prateekspawar/Airbus_Gripper_design_challenge/circuit diagram/ir.jpg

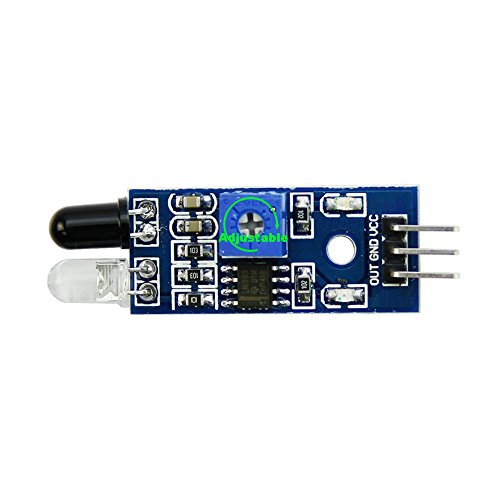
circuit diagram/ir.jpg
