prateekspawar/Airbus_Gripper_design_challenge/circuit diagram/servo.jpg

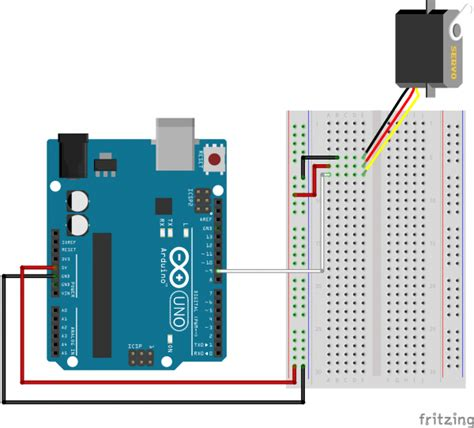
circuit diagram/servo.jpg
