prateekspawar/Airbus_Gripper_design_challenge/README.md

# Airbus_Gripper_design_challenge
## Final submission report [here](Grasping%20System%20-%20Submission%20Prateek%20Pawar.pdf).
