prateekspawar/Airbus_Gripper_design_challenge/servo.txt

https://robokits.co.in/motors/rc-servo-motors/metal-gear-dual-shaft-16kgcm-digital-servo-motor

https://robu.in/product/towerpro-mg995-metal-gear-servo-motor/

https://robokits.co.in/robot-parts/servo-brackets-accessories/servo-accessory-pack-for-dual-shaft-servo

https://robokits.co.in/motors/rc-servo-motors/metal-horn-for-servo-25t

https://robokits.co.in/sensors/ir-and-pir-sensors/ir-obstacle-sensor-module
