prateekspawar/Airbus_Gripper_design_challenge/RKI-1206.pdf

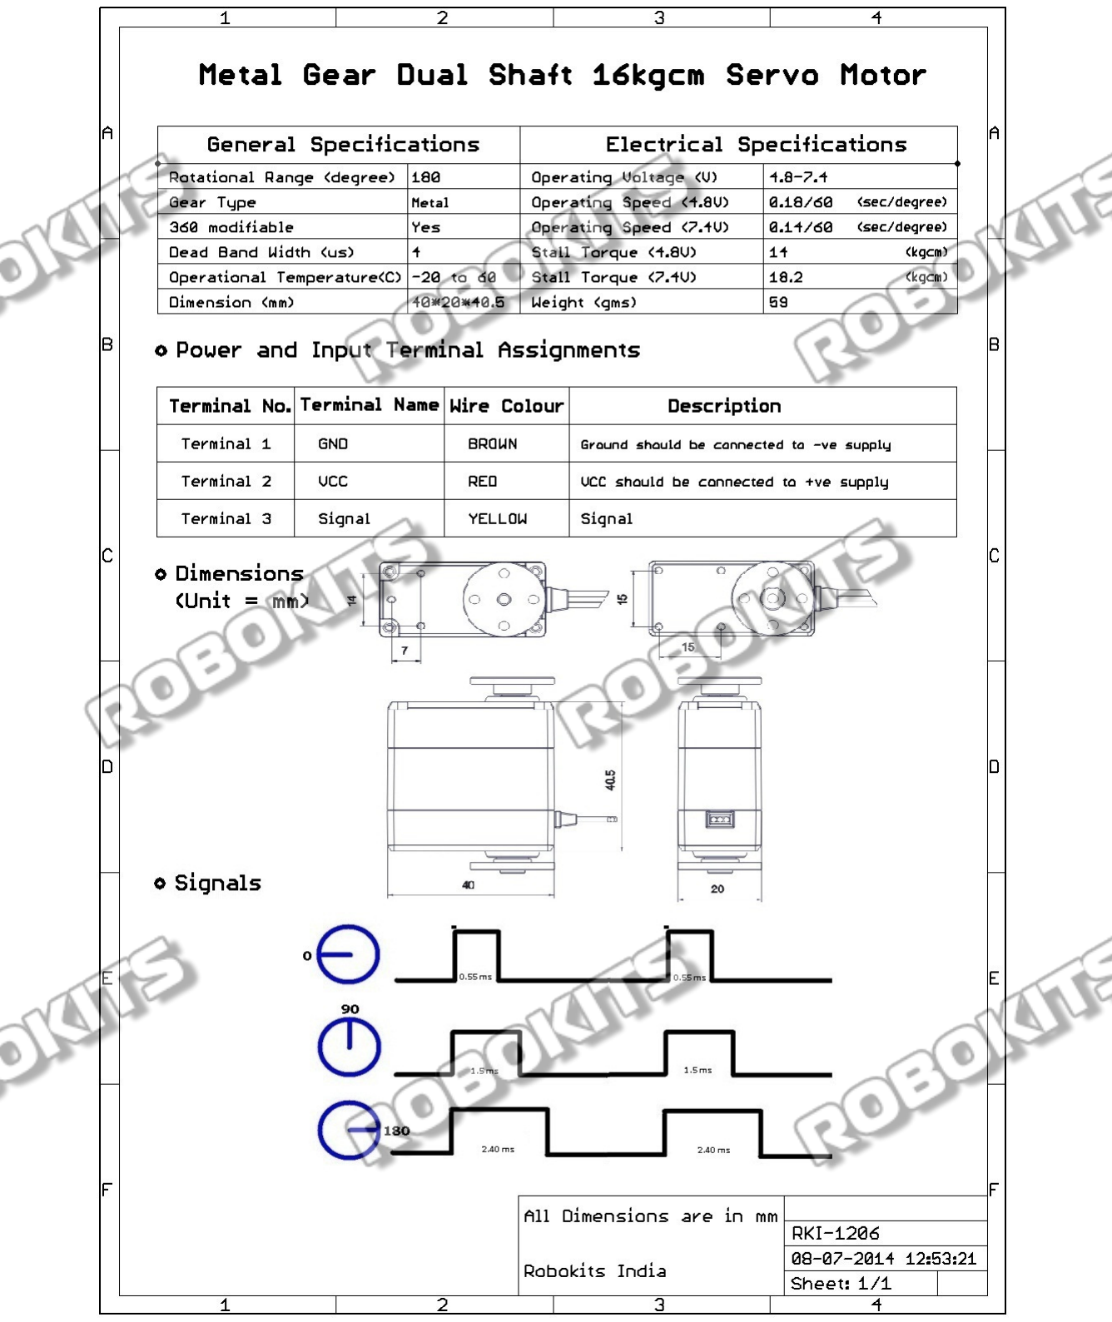
[picture p26: page 1]
