prateekspawar/Airbus_Gripper_design_challenge/circuit diagram/ultrasonic.jpg

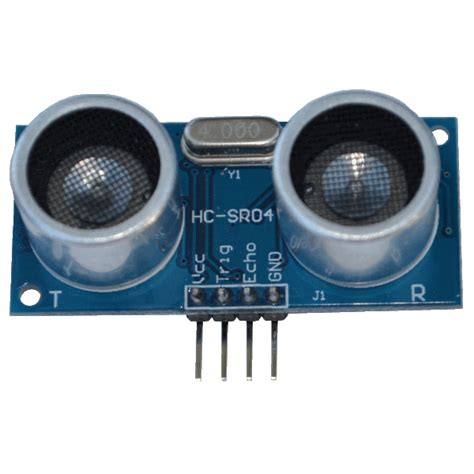
circuit diagram/ultrasonic.jpg
