prateekspawar/Airbus_Gripper_design_challenge/solidwrks/Screenshot (31).png

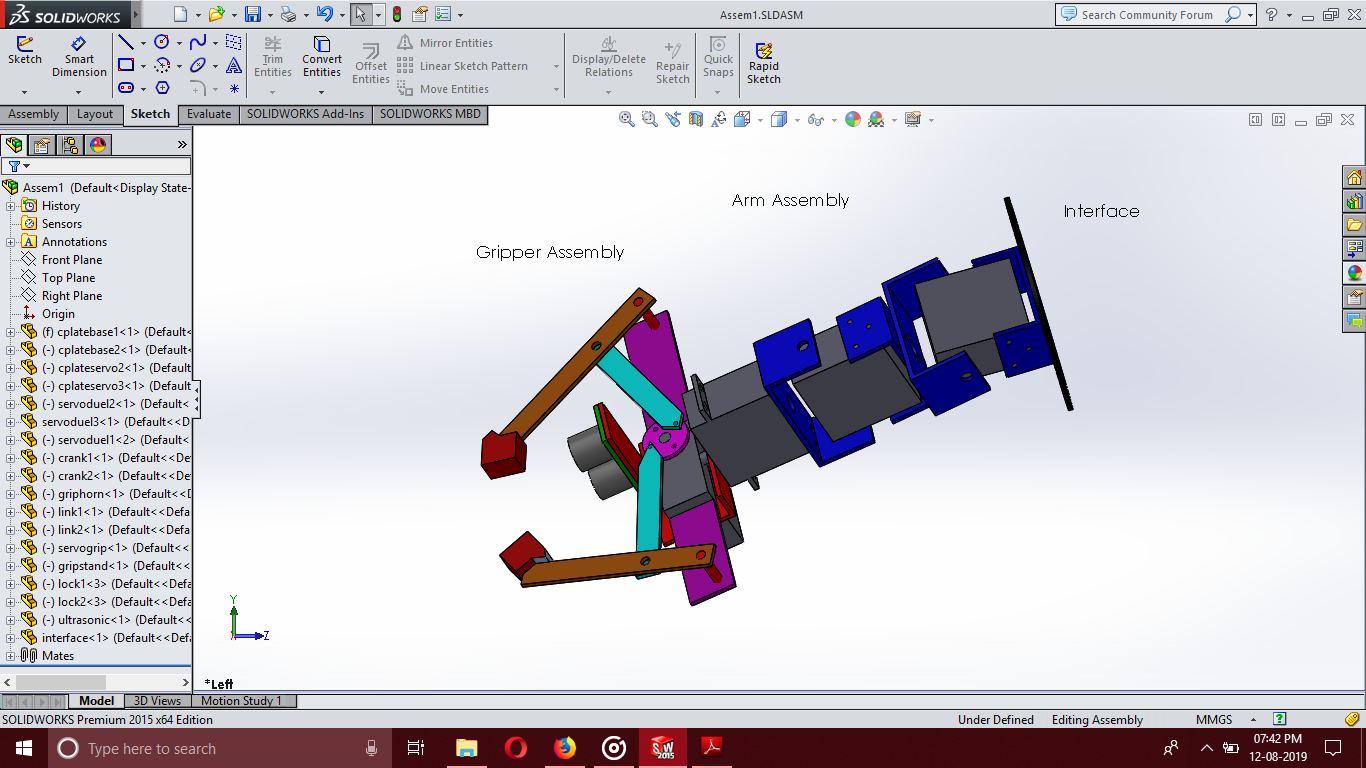
solidwrks/Screenshot (31).png
