prateekspawar/Airbus_Gripper_design_challenge/solidwrks/Screenshot (32).png

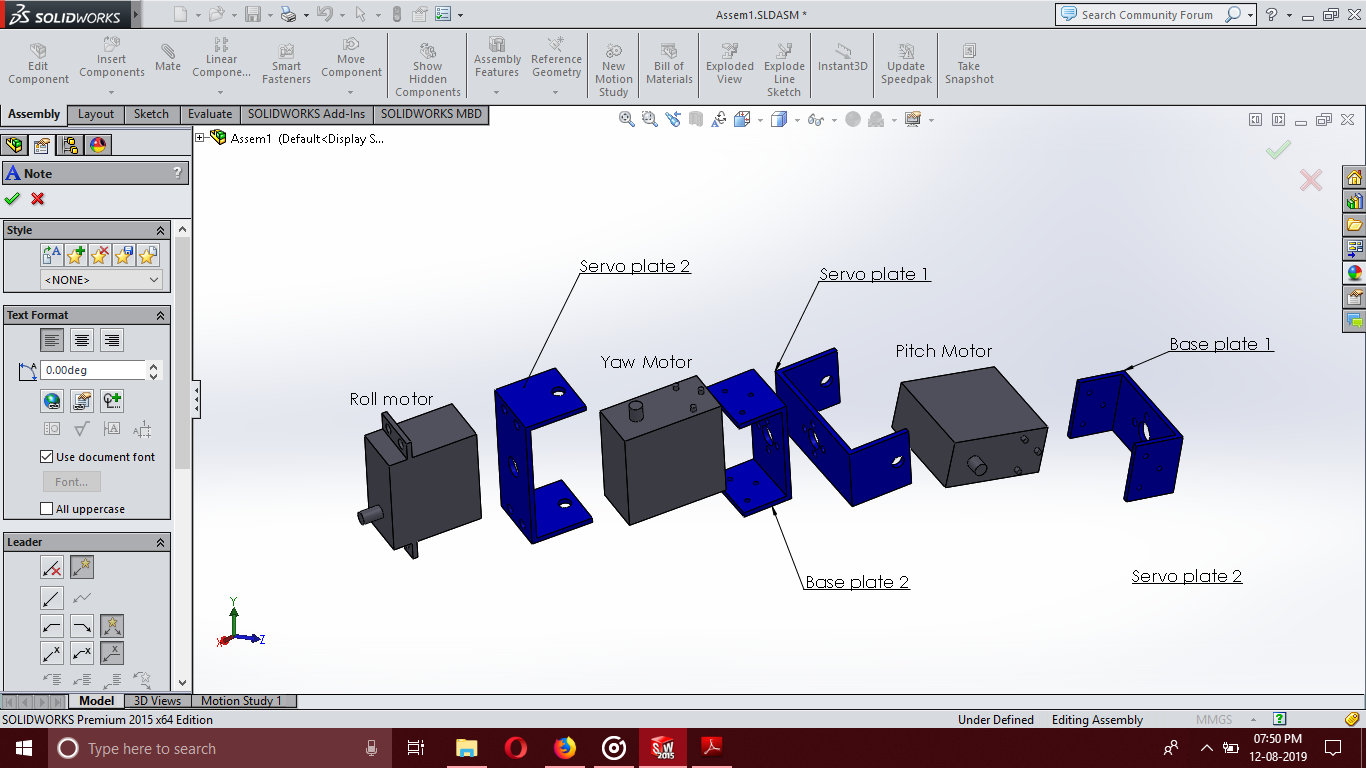
solidwrks/Screenshot (32).png
