prateekspawar/Airbus_Gripper_design_challenge/solidwrks/Screenshot (35).png

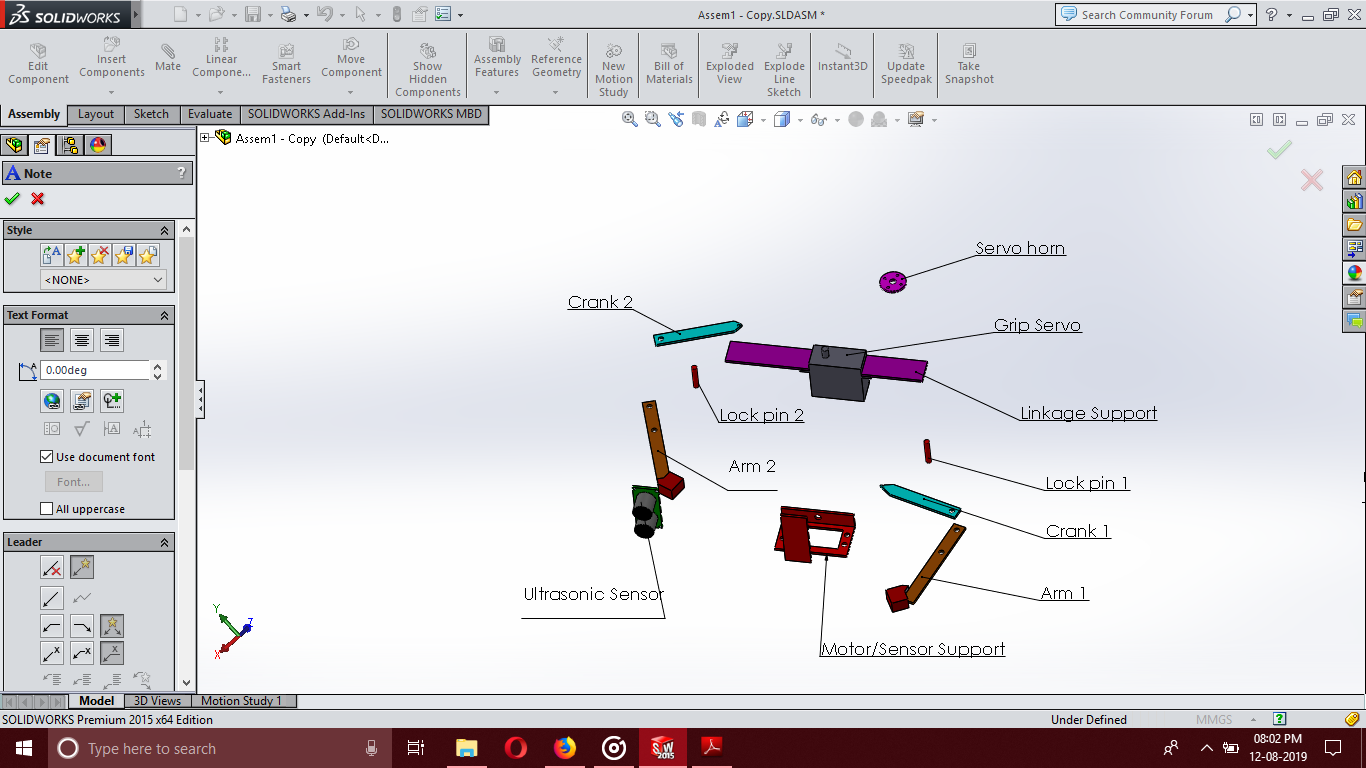
solidwrks/Screenshot (35).png
