prateekspawar/Airbus_Gripper_design_challenge/solidwrks/Screenshot (57).png

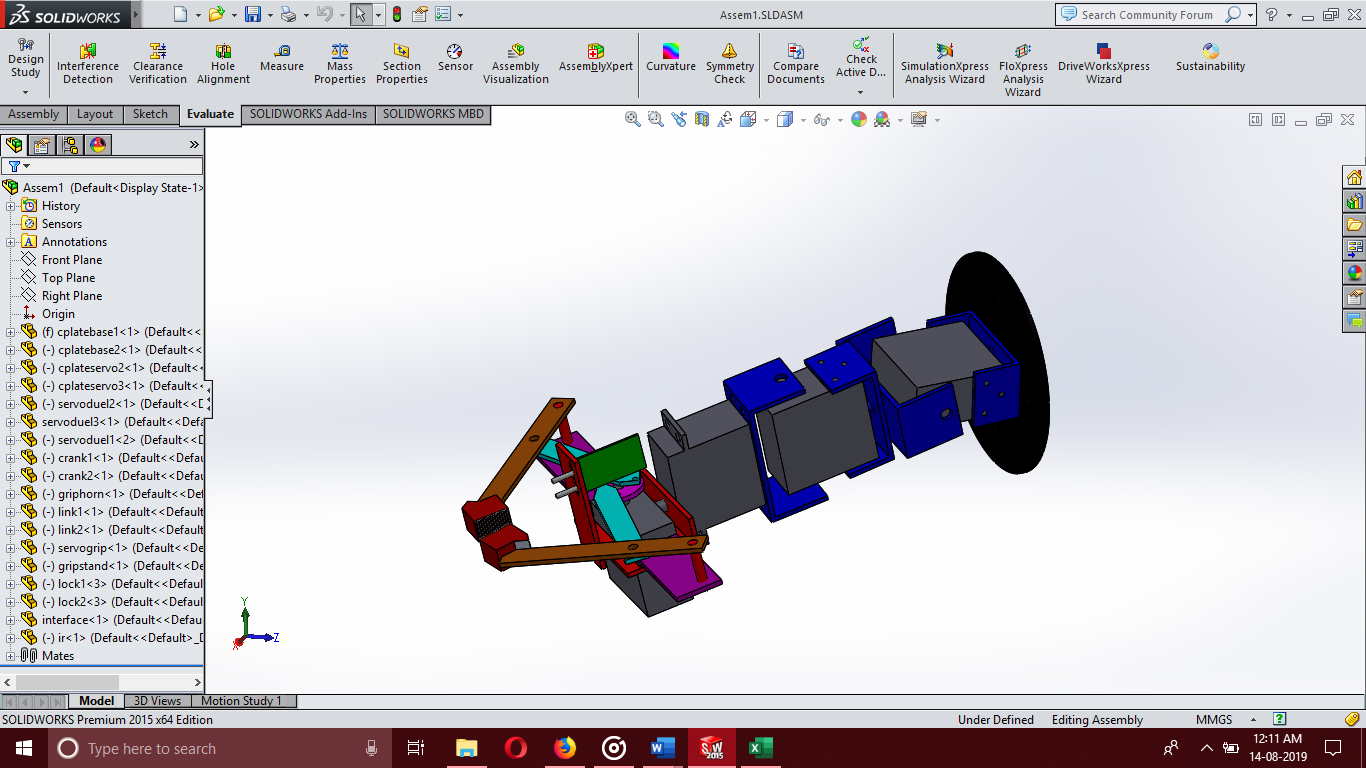
solidwrks/Screenshot (57).png
