prateekspawar/Airbus_Gripper_design_challenge/solidwrks/Screenshot (66).png

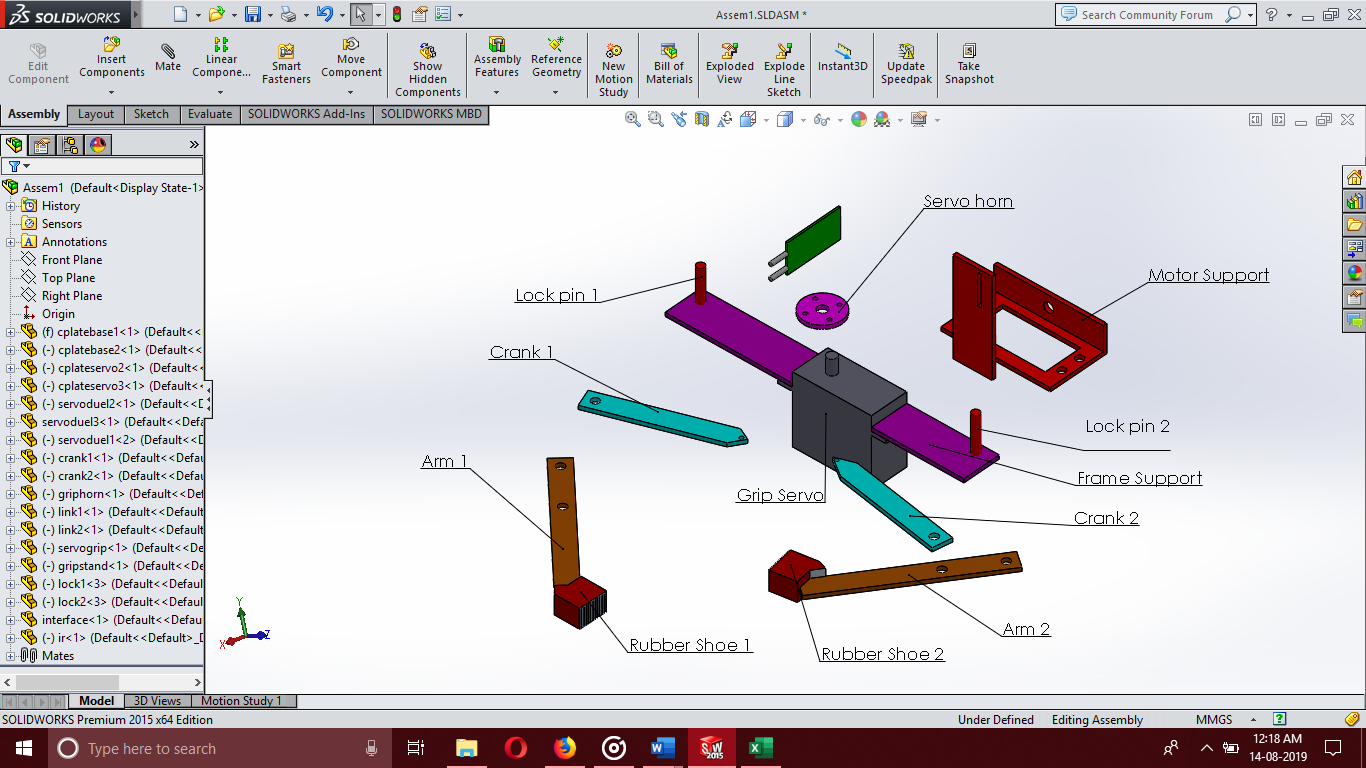
solidwrks/Screenshot (66).png
