prateekspawar/Airbus_Gripper_design_challenge/solidwrks/Screenshot (67).png

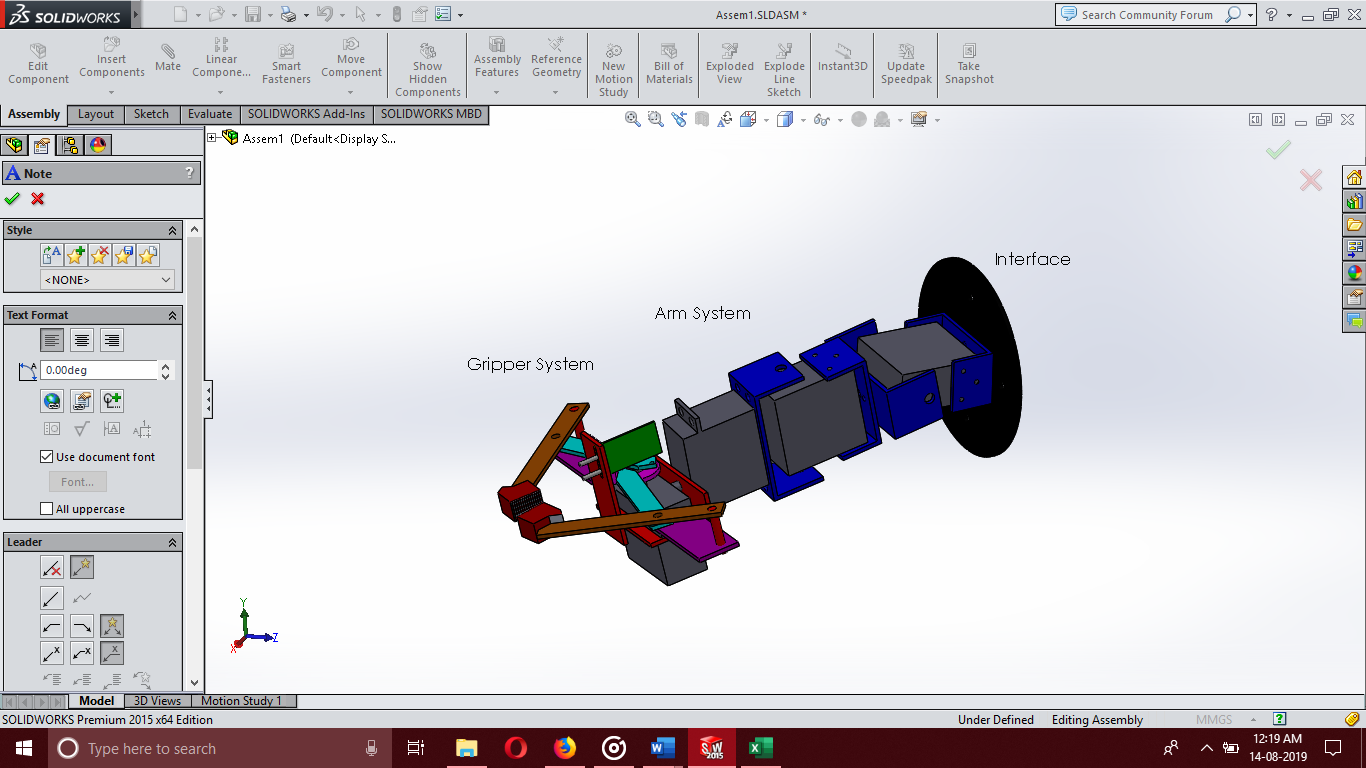
solidwrks/Screenshot (67).png
