prateekspawar/Airbus_Gripper_design_challenge/solidwrks/Assem1.SLDASM

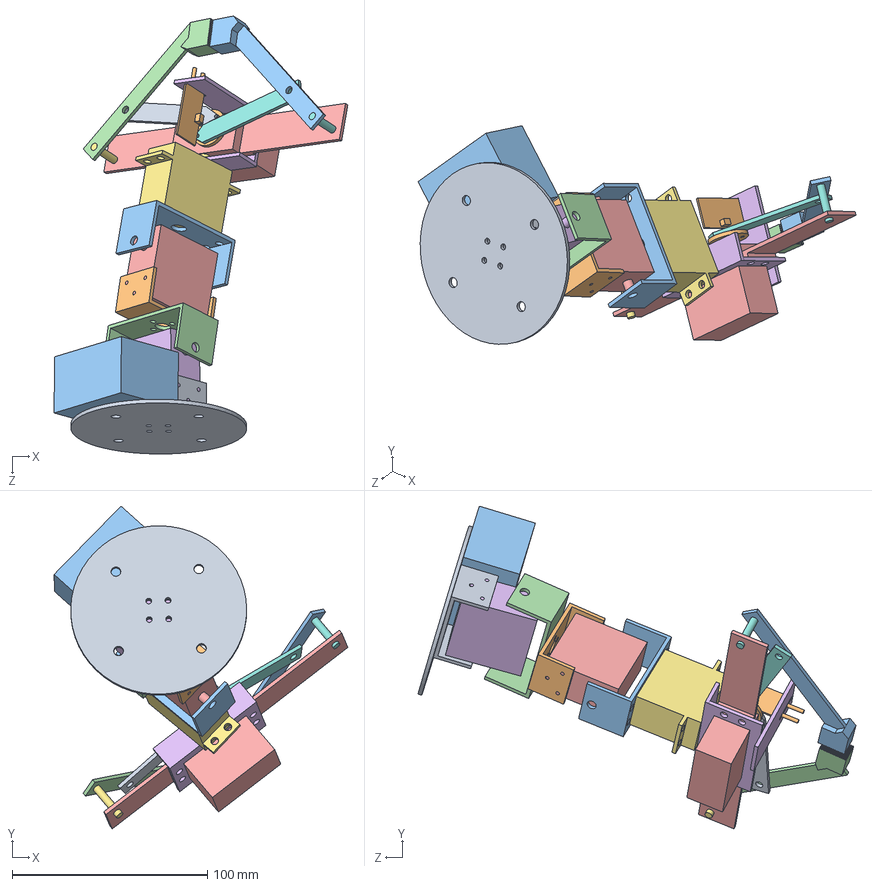
[picture p34: CAD file, 2020-05-11]
solidwrks/Assem1.SLDASM
150.3 x 165.1 x 224.1 mm
cplatebase1
cplatebase2
cplateservo2
cplateservo3
servoduel2
servoduel3
servoduel1
crank1
crank2
griphorn
link1
link2
servogrip
gripstand
lock1
lock2
interface
ir
electronics box
