prateekspawar/Airbus_Gripper_design_challenge/solidwrks/drawings/Arm/cplateservo3.SLDPRT

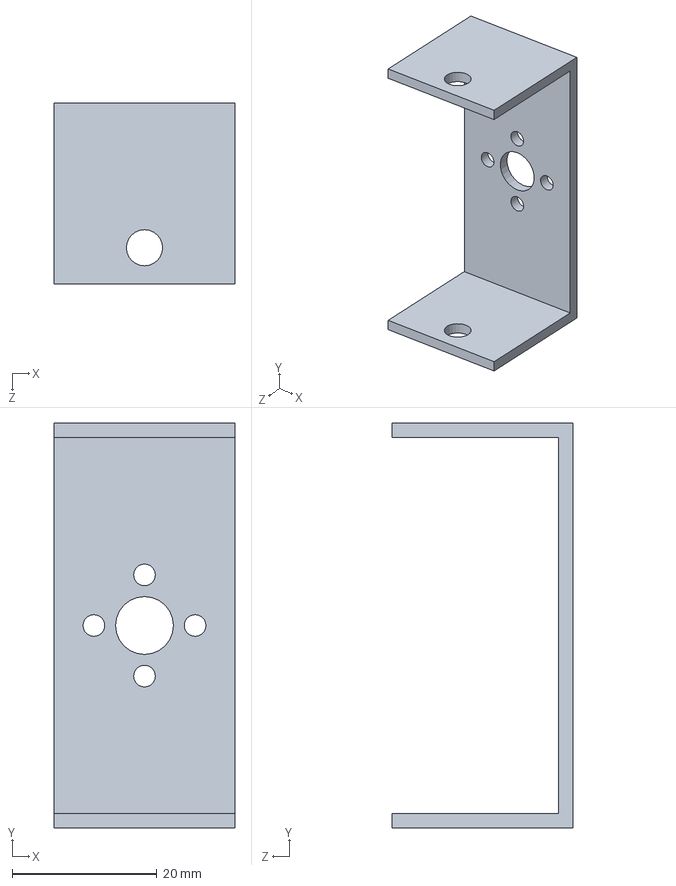
[picture p35: CAD file, 2020-05-11]
solidwrks/drawings/Arm/cplateservo3.SLDPRT
25.0 x 56.0 x 25.0 mm
