prateekspawar/Airbus_Gripper_design_challenge/solidwrks/drawings/gripper/arm1.SLDPRT

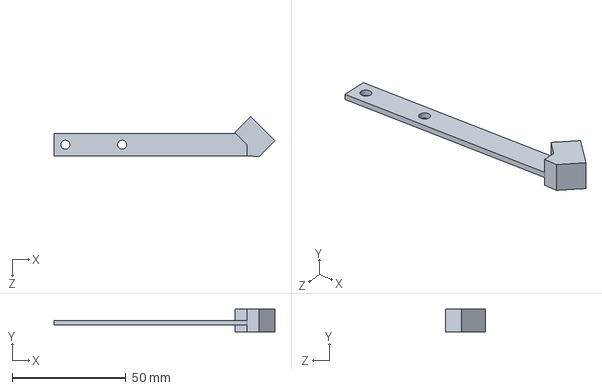
[picture p36: CAD file, 2020-05-11]
solidwrks/drawings/gripper/arm1.SLDPRT
97.3 x 10.0 x 17.7 mm
