prateekspawar/Airbus_Gripper_design_challenge/solidwrks/drawings/interface/interface.SLDPRT

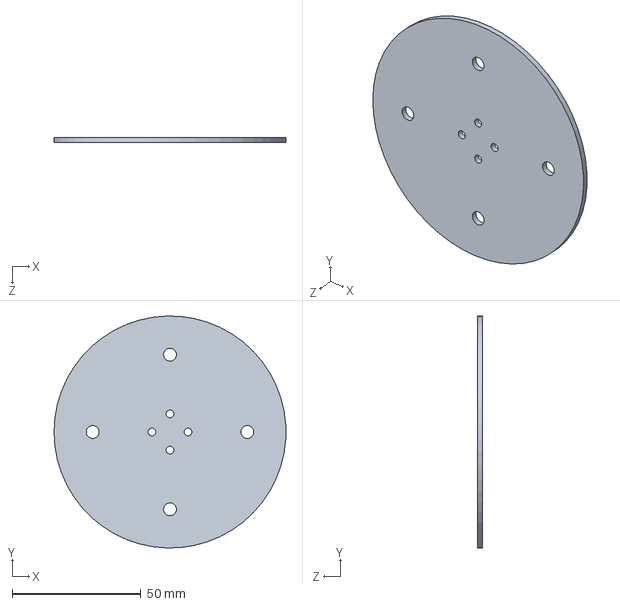
[picture p37: CAD file, 2020-05-11]
solidwrks/drawings/interface/interface.SLDPRT
90.0 x 90.0 x 2.00 mm
