prateekspawar/Airbus_Gripper_design_challenge/solidwrks/gripstand.SLDPRT

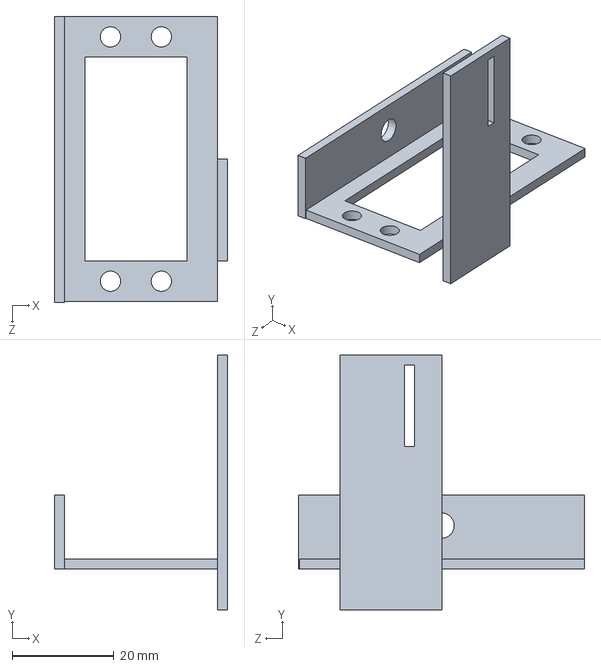
[picture p38: CAD file, 2020-05-11]
solidwrks/gripstand.SLDPRT
34.0 x 50.0 x 56.2 mm
