prateekspawar/Airbus_Gripper_design_challenge/solidwrks/cplateservo2.SLDPRT

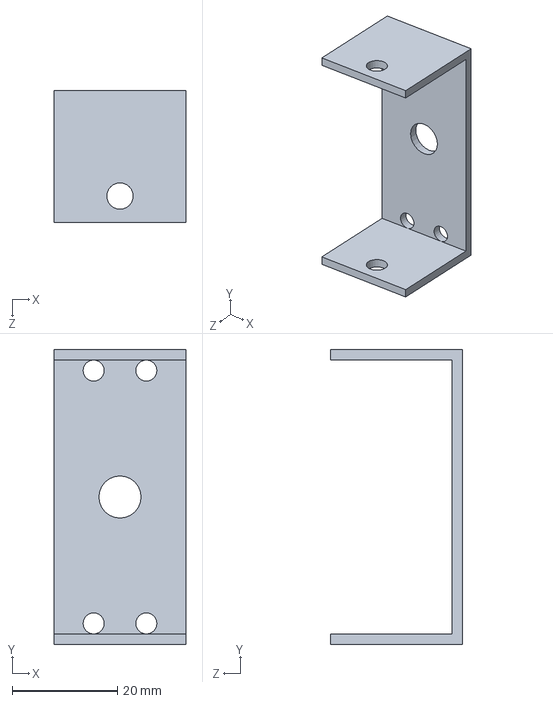
[picture p39: CAD file, 2020-05-11]
solidwrks/cplateservo2.SLDPRT
25.0 x 56.0 x 25.0 mm
