prateekspawar/Airbus_Gripper_design_challenge/solidwrks/drawings/Arm/cplatebase2.SLDPRT

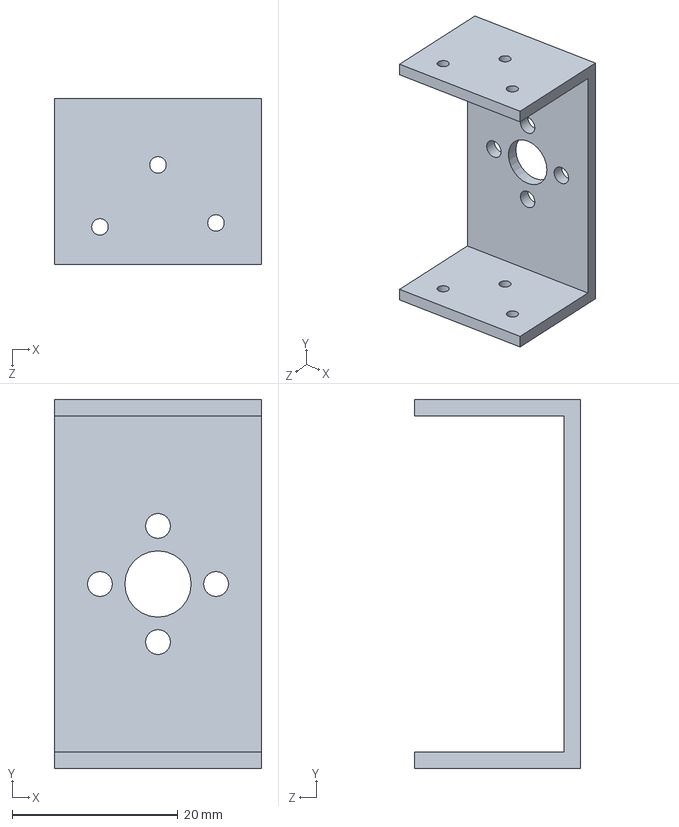
[picture p40: CAD file, 2020-05-11]
solidwrks/drawings/Arm/cplatebase2.SLDPRT
25.0 x 44.5 x 20.0 mm
