prateekspawar/Airbus_Gripper_design_challenge/solidwrks/drawings/gripper/crank2.SLDPRT

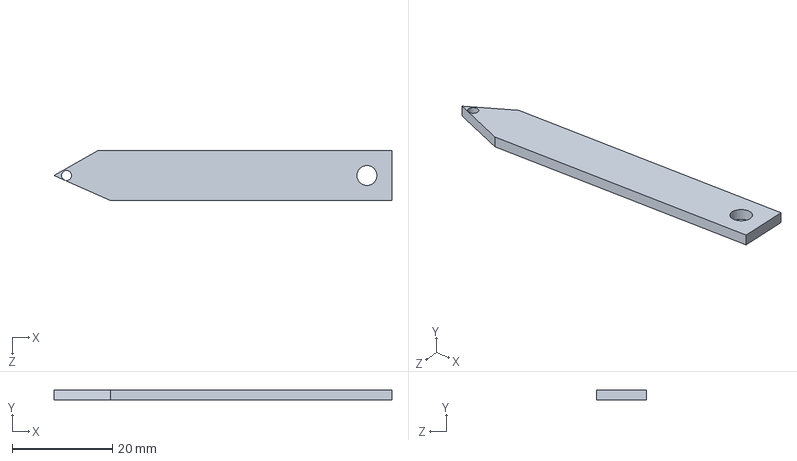
[picture p41: CAD file, 2020-05-11]
solidwrks/drawings/gripper/crank2.SLDPRT
67.5 x 2.00 x 10.0 mm
