prateekspawar/Airbus_Gripper_design_challenge/solidwrks/drawings/Arm/servoyaw.SLDPRT

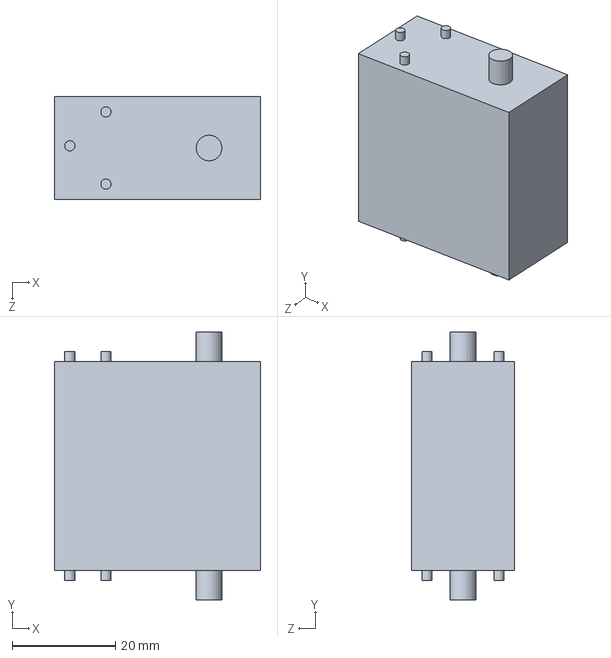
[picture p42: CAD file, 2020-05-11]
solidwrks/drawings/Arm/servoyaw.SLDPRT
40.0 x 52.0 x 20.0 mm
