prateekspawar/Airbus_Gripper_design_challenge/solidwrks/drawings/gripper/servogrip.SLDPRT

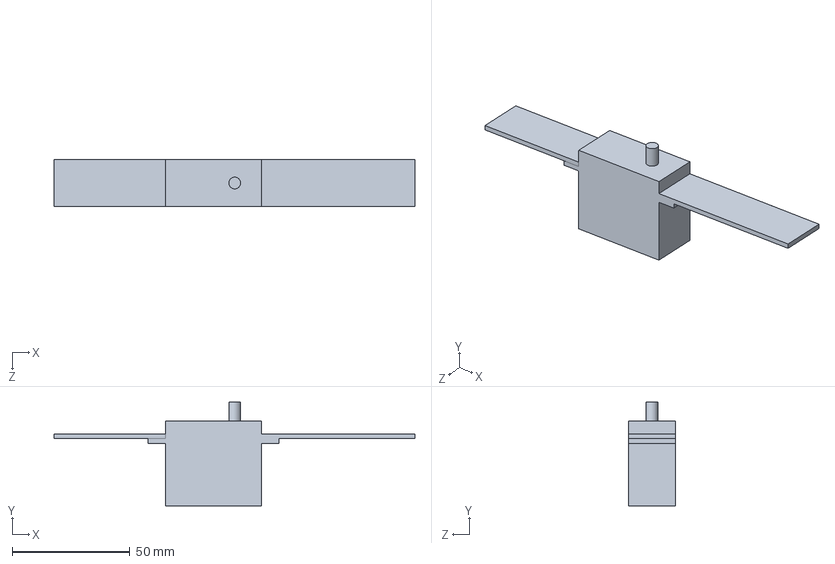
[picture p43: CAD file, 2020-05-11]
solidwrks/drawings/gripper/servogrip.SLDPRT
153.1 x 44.1 x 20.0 mm
