prateekspawar/Airbus_Gripper_design_challenge/solidwrks/lock1.SLDPRT

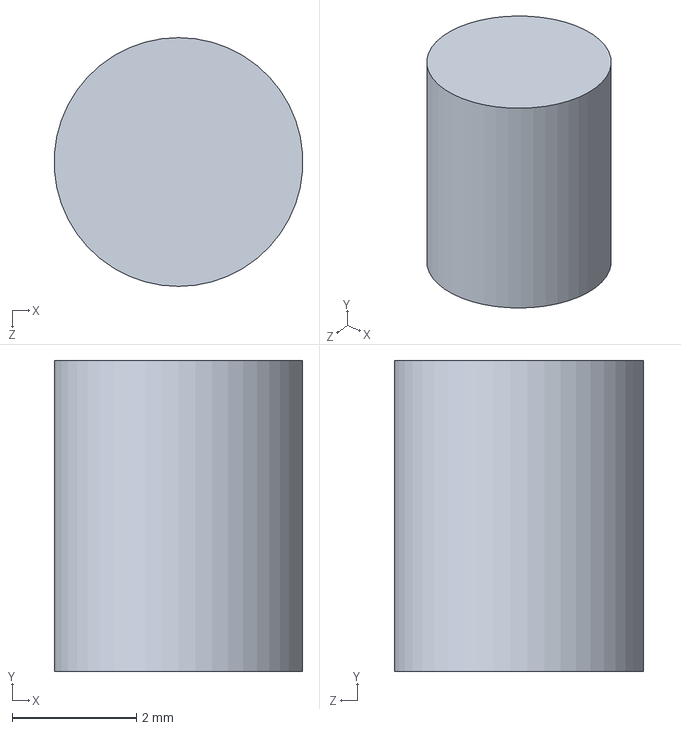
[picture p44: CAD file, 2020-05-11]
solidwrks/lock1.SLDPRT
3.99 x 5.00 x 4.00 mm
