prateekspawar/Airbus_Gripper_design_challenge/solidwrks/drawings/gripper/arm2.SLDPRT

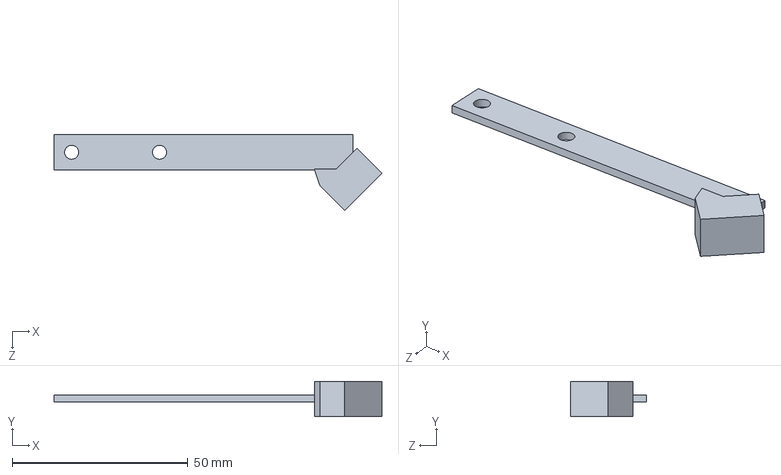
[picture p45: CAD file, 2020-05-11]
solidwrks/drawings/gripper/arm2.SLDPRT
93.2 x 10.0 x 21.5 mm
