prateekspawar/Airbus_Gripper_design_challenge/solidwrks/drawings/Arm/servoroll.SLDPRT

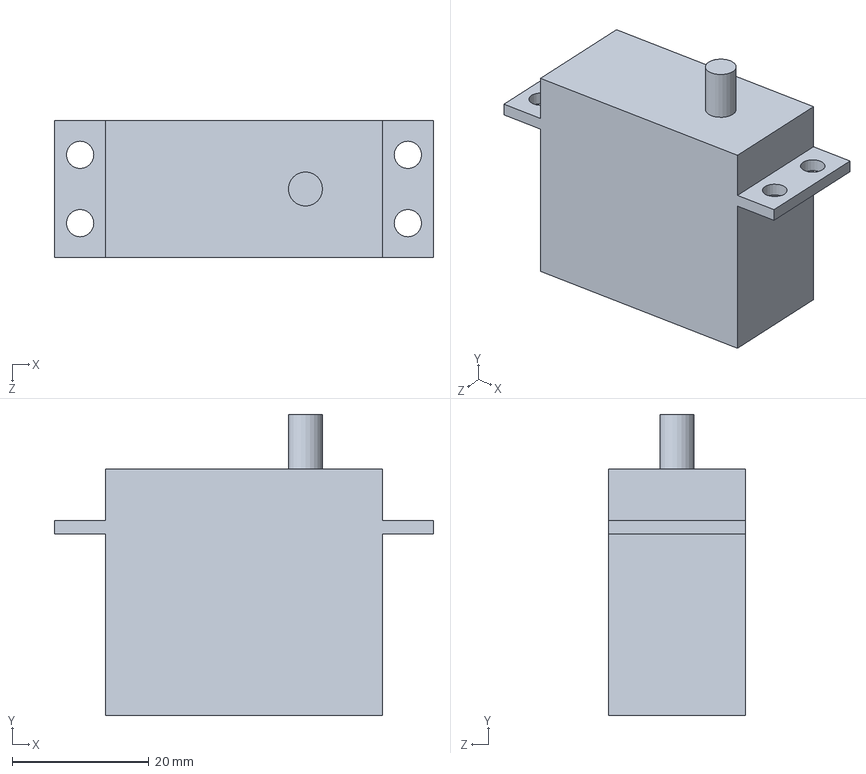
[picture p46: CAD file, 2020-05-11]
solidwrks/drawings/Arm/servoroll.SLDPRT
55.5 x 44.1 x 20.0 mm
