prateekspawar/Airbus_Gripper_design_challenge/solidwrks/cplateservo1.SLDPRT

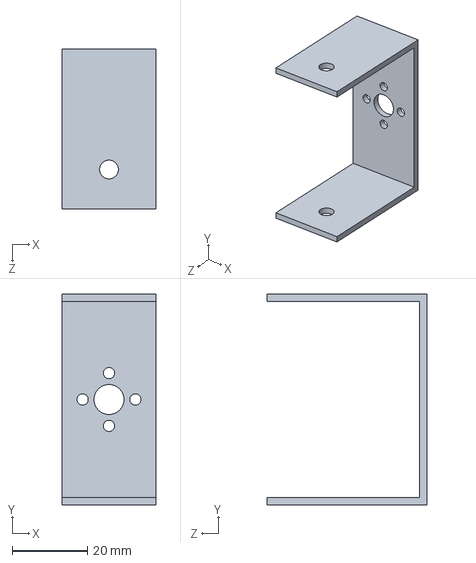
[picture p47: CAD file, 2020-05-11]
solidwrks/cplateservo1.SLDPRT
25.0 x 56.0 x 42.5 mm
