prateekspawar/Airbus_Gripper_design_challenge/solidwrks/drawings/gripper/servohorn.SLDPRT

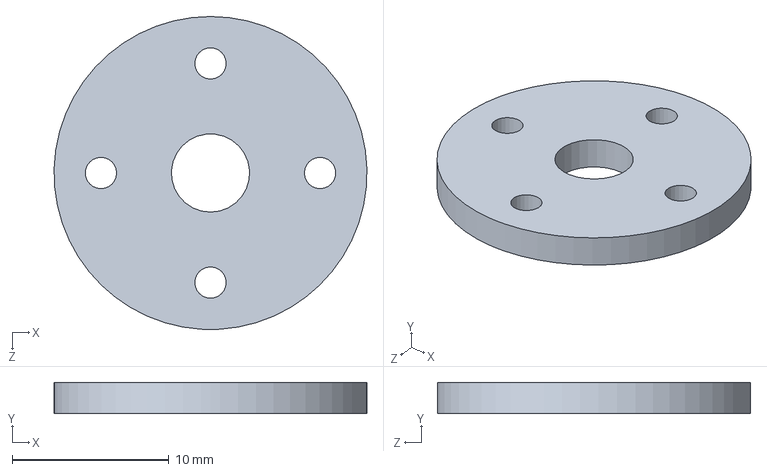
[picture p48: CAD file, 2020-05-11]
solidwrks/drawings/gripper/servohorn.SLDPRT
20.0 x 2.00 x 20.0 mm
