prateekspawar/Airbus_Gripper_design_challenge/solidwrks/drawings/gripper/ultrasonic.SLDPRT

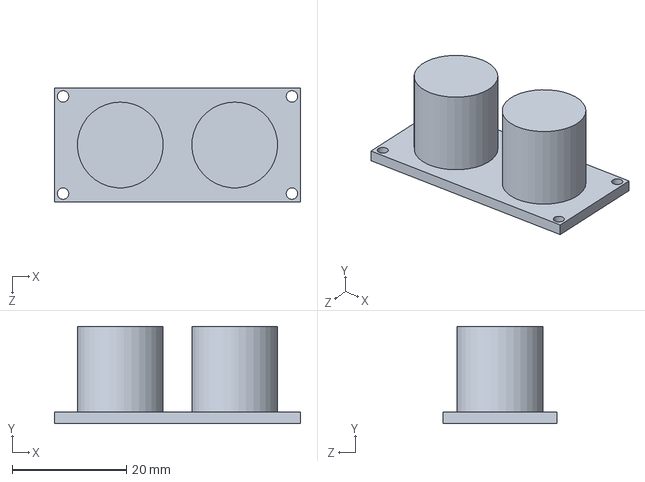
[picture p49: CAD file, 2020-05-11]
solidwrks/drawings/gripper/ultrasonic.SLDPRT
43.0 x 17.0 x 20.0 mm
