prateekspawar/Airbus_Gripper_design_challenge/solidwrks/link1.SLDPRT

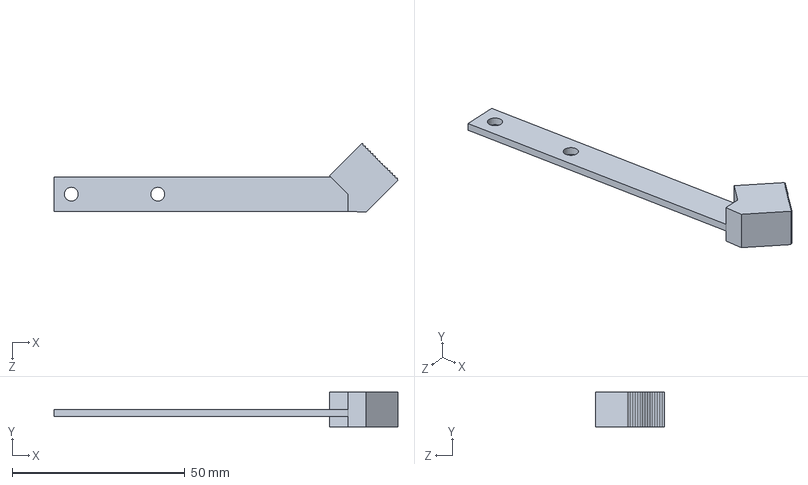
[picture p50: CAD file, 2020-05-11]
solidwrks/link1.SLDPRT
99.4 x 10.0 x 19.8 mm
