prateekspawar/Airbus_Gripper_design_challenge/solidwrks/link2.SLDPRT

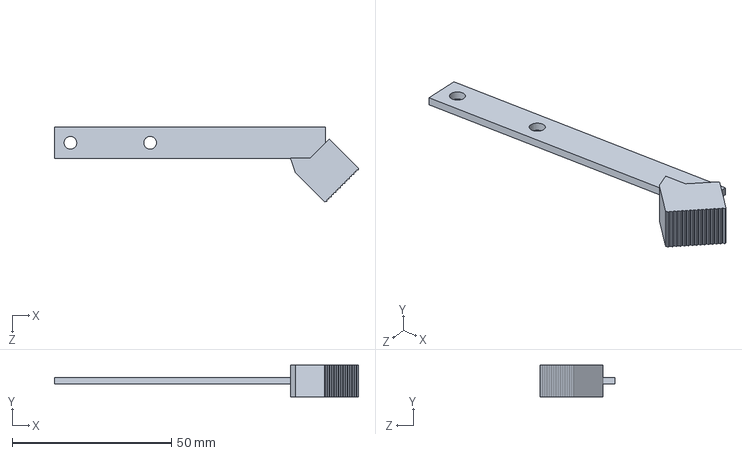
[picture p51: CAD file, 2020-05-11]
solidwrks/link2.SLDPRT
95.4 x 10.0 x 23.6 mm
