prateekspawar/Airbus_Gripper_design_challenge/solidwrks/ir.SLDPRT

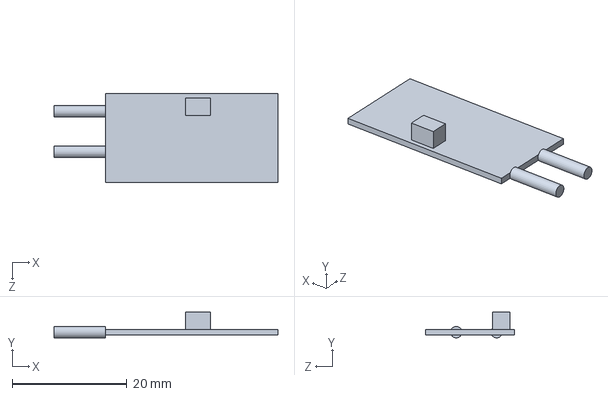
[picture p52: CAD file, 2020-05-11]
solidwrks/ir.SLDPRT
39.0 x 4.50 x 15.5 mm
