prateekspawar/Airbus_Gripper_design_challenge/solidwrks/electronics box.SLDPRT

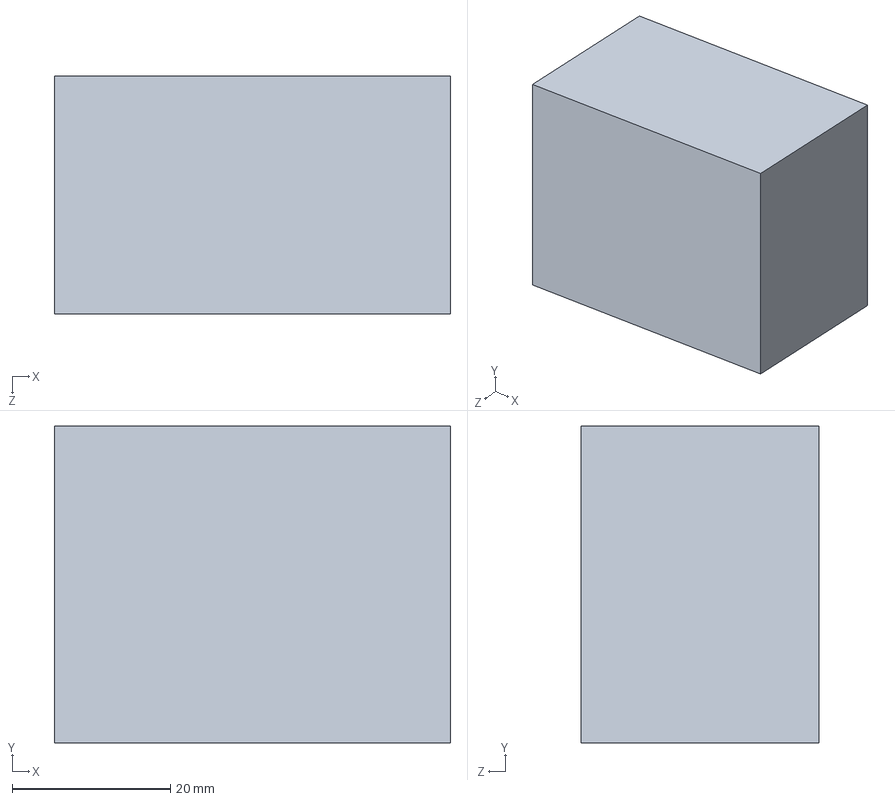
[picture p53: CAD file, 2020-05-11]
solidwrks/electronics box.SLDPRT
50.0 x 40.0 x 30.0 mm
