prateekspawar/Airbus_Gripper_design_challenge/(list of files, cad)

Other CAD files:
solidwrks/drawings/Arm/servopitch.SLDPRT
solidwrks/drawings/gripper/crank1.SLDPRT
solidwrks/interface.SLDPRT
solidwrks/cplatebase2.SLDPRT
solidwrks/drawings/Arm/cplateservo2.SLDPRT
solidwrks/drawings/gripper/lock2.SLDPRT
solidwrks/servoduel2.SLDPRT
solidwrks/cplatebase3.SLDPRT
solidwrks/drawings/Arm/cplatebase1.SLDPRT
solidwrks/drawings/gripper/lock pin.SLDPRT
solidwrks/cplatebase1.SLDPRT
solidwrks/drawings/gripper/support.SLDPRT
solidwrks/lock2.SLDPRT
solidwrks/cplateservo3.SLDPRT
solidwrks/griphorn.SLDPRT
solidwrks/servoduel1.SLDPRT
solidwrks/crank1.SLDPRT
solidwrks/servoduel3.SLDPRT
solidwrks/servogrip.SLDPRT
solidwrks/crank2.SLDPRT
mechanism.CATPart
solidwrks/Assem1 - Copy.SLDASM
solidwrks/drawings/Arm/baseplate1.SLDDRW
solidwrks/drawings/Arm/servopitch.SLDDRW
solidwrks/drawings/Arm/servoplate.SLDDRW
solidwrks/drawings/Arm/servoroll.SLDDRW
solidwrks/drawings/Arm/servoyaw.SLDDRW
solidwrks/drawings/gripper/arm1.SLDDRW
solidwrks/drawings/gripper/arm2.SLDDRW
solidwrks/drawings/gripper/crank1.SLDDRW
solidwrks/drawings/gripper/crank2.SLDDRW
solidwrks/drawings/gripper/ir.SLDDRW
solidwrks/drawings/gripper/lock pin.SLDDRW
solidwrks/drawings/gripper/servogrip.SLDDRW
solidwrks/drawings/gripper/servohorn.SLDDRW
solidwrks/drawings/gripper/support.SLDDRW
solidwrks/drawings/gripper/ultrasonic.SLDDRW
solidwrks/drawings/interface/interface.SLDDRW
