prateekspawar/Airbus_Gripper_design_challenge/submit/flow chart.pdf

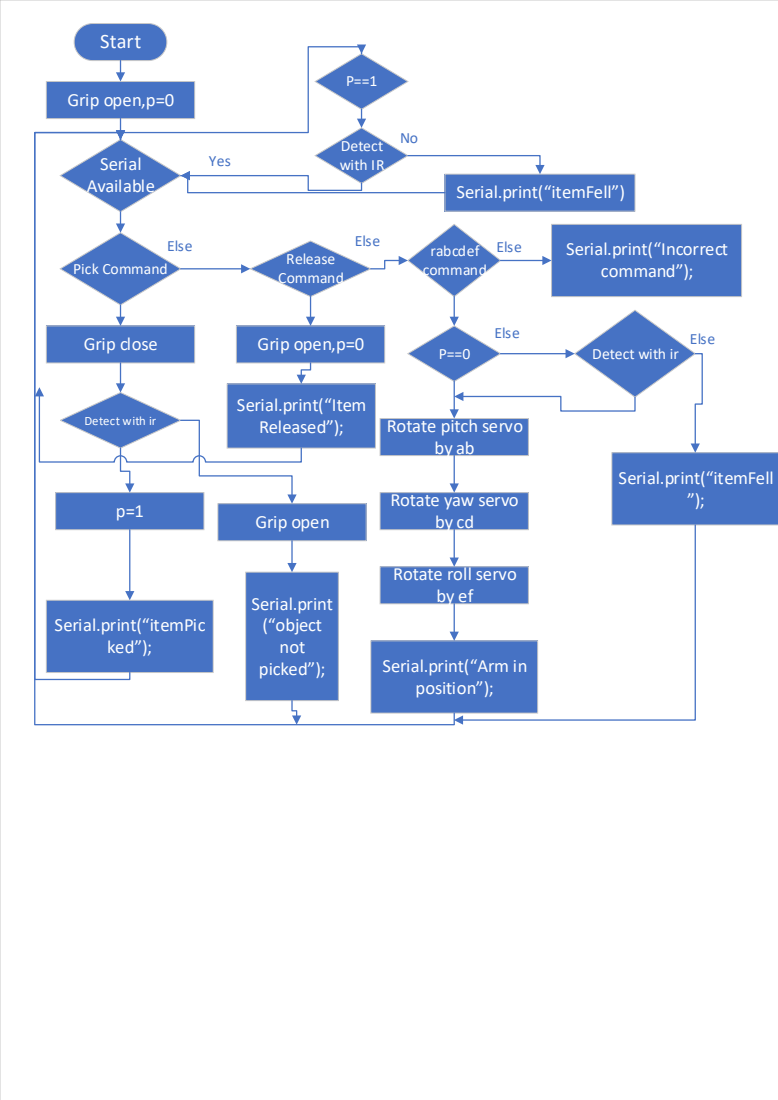
[picture p54: page 1]
Start; Grip open,p=0; Serial Available; Pick Command; Grip close; Release Command; rabcdef command; Else; Serial.print(“Incorrect; command”);; Grip open; Serial.print (“object not picked”);; Detect with IR; Yes

Serial.print(“itemFell”)

Detect with ir

Serial.print(“Item
Released”);

Rotate pitch servo

Serial.print(“itemFell

Rotate yaw servo

Rotate roll servo

Serial.print(“itemPic
ked”);

Serial.print(“Arm in
position”);
